LuniTech/DualSlopeIntegratorADC/Multisim Convergence Assistant Report.txt

Multisim Convergence Assistant Log 
 
Step 1: Verifying Error Scenario
	...could not reproduce the error
