LuniTech/DualSlopeIntegratorADC/(list of files, drawings)

Other design files:
1-MainDesign(New modification).ms14
1-MainDesign.ms14
2-SignalConditioning.ms14
Experimental Schematics/1-MainDesign.ms14
Experimental Schematics/2-SignalConditioning.ms14
Experimental Schematics/3- DualSlopeIntegratorStandAlone.ms14
Experimental Schematics/3-SwitchStandAlone.ms14
Experimental Schematics/5-ComparatorFinalStopCondition.ms14
Experimental Schematics/CounterAndSwitchMechanism.ms14
Experimental Schematics/IntegratorWithComparator.ms14
